BryanHaven/raven-animatronic/README.docx

Animatronic Bird Controller — v4.1

ESP32-based WiFi controller for animatronic props built around the Mr. Chicken's Prop Shop Animatronic Raven Kit and compatible builds. v4 adds a captive portal for first-time WiFi/MQTT setup, full runtime device configuration, and a three-level MQTT topic hierarchy. v4.1 hardens the firmware with OTA updates, hardware watchdog, MQTT last will, and WiFi auto-reconnect.

> Upgrading from v3? The only breaking change is that WiFi and MQTT credentials are no longer in raven_config.h. On first boot v4 will launch the setup AP.

# Version History

Version | Summary
v4.1.1 | Bug fixes: watchdog API corrected; captive portal validates required fields; firmware fallback populates blank name/hostname from Device ID
v4.1 | Show hardening: OTA firmware updates, hardware watchdog (30s), MQTT last will, WiFi auto-reconnect with exponential backoff
v4.0 | Captive portal setup (BirdSetup AP), runtime config.json, three-level MQTT hierarchy, Settings tab, Reset to AP mode, identity announcement
v3.0 | mDNS, live sequence indicator, SPIFFS-persisted servo calibration, keyframe sequence editor, MQTT Home Assistant discovery
v2.0 | I2S audio (MAX98357A), dynamic sound library, WAV upload via web UI
v1.0 | Initial release: DAC audio, static soundboard, ESPAsyncWebServer, WebSocket control

# Planned Features (v5+)

Feature | Notes
Kit-agnostic architecture | kit.json defines servo mapping, NeoPixel config, and personality per prop type
Glowing eyes | WS2812B/WS2813 LEDs behind glass lenses — daisy-chained on NeoPixel line as pixels 1 & 2, status LED becomes pixel 0. Eye color, effects, and blink timing defined per-kit in kit.json
Random idle behavior | Background task — random head/beak movements between cues, configurable interval
Conductor mode | One MQTT message fans out a timed sequence to multiple birds in a room
Startup sync | All birds in a room wait for a sync message before moving to neutral
Export/import config | Download full config as zip, clone to new bird by uploading
OTA SPIFFS update | Currently OTA covers firmware only — add filesystem update support
Physical trigger input | 3.5mm jack to GPIO 34, fires configurable sequence on contact closure
Current sensing | INA219 on VS+ rail — detect stalled/disconnected servos
Audio volume control | Configurable gain via MAX98357A GAIN pin
Audio ducking | Lower ambient audio level during cue sequences
Looping ambient audio | /audio/loop command for continuous background sound
Cue numbers | Numeric /cue topic mapping integers to sequence names for QLab/Isadora
Status LED | NeoPixel showing WiFi/MQTT/sequence state

# What's New in v4.1 — Show Hardening

- OTA firmware updates — flash new firmware over WiFi without USB. Password defaults to the device's Device ID.
- Hardware watchdog — 30-second timeout. If the firmware hangs the ESP32 automatically reboots.
- MQTT last will — the broker publishes offline to {prefix}/status when a bird drops off unexpectedly.
- WiFi auto-reconnect — retries with exponential backoff: 5s to 10s to 20s to 40s to 60s cap.

# What's New in v4.0

- Captive portal setup — on first boot the ESP32 becomes a WiFi access point called BirdSetup.
- Runtime device configuration — all identity, WiFi, and MQTT settings live in config.json on SPIFFS.
- Three-level MQTT topic hierarchy — location/room/device (e.g. props/tiki_bar/parrot1).
- Settings tab — edit device name, hostname, MQTT prefix, broker, and WiFi from the browser.
- Reset to AP mode — one button in Settings wipes config.json and restarts as BirdSetup.
- Identity announcement — on MQTT connect the bird publishes its name, hostname, IP, and full topic prefix.
- Multi-prop ready — flash the same firmware to every bird, configure each individually.

# Hardware

## Raven Mechanic Kit

Mr. Chicken's Prop Shop — Animatronic Raven Kit

https://chickenprops.com/products/animatronic-raven-kit

Available in Basic (mechanical parts only), Deluxe (Basic + servos), and Bare Bones (custom parts only).

## Servos

Qty | Part | Role
1x | Hitec HS-53 | Beak open/close
3x | Hitec HS-425BB | Head pan, head tilt, body bob
1x | Hitec HS-645MG | Wings (single servo, both wings mechanically linked)

## Electronics

Component | Exact Part | Notes
Microcontroller | DOIT ESP32 DevKit V1 (30-pin WROOM) | Any esp32dev board works
Carrier PCB | Raven Animatronic Controller PCB v1.0 | 100x60mm, JLCPCB fabricated — see /pcb directory
Servo Controller | Lynxmotion SSC-32U | USB + full-duplex UART
Audio Amplifier | Adafruit MAX98357A I2S Breakout — PID: 3006 | 3W Class D, I2S input
Speaker | Adafruit Mono Enclosed Speaker 3W 4 Ohm — PID: 4445 | 2.8 x 1.2 inch, bare wire leads
Current Monitor | INA219BIDR (SOIC-8) | Monitors servo current on +7.5V rail, I2C address 0x40
Servo PSU | Mean Well GST60A07-P1J (7.5V 5A, 37.5W) | See Power Supplies section
Logic PSU | Mean Well GST25A05-P1J (5V 4A, 20W) | Powers ESP32 + MAX98357A

# Power Supplies

Three separate power domains — keep them isolated.

## Domain 1 — Servos (6-7.5V, high current)

Mean Well GST60A07-P1J — 7.5V, 5A, 37.5W. The SSC-32U has an adjustable trimmer — trim down to 6V if your servos prefer it.

- IEC C14 inlet — requires IEC C13 power cord (not included)
- Connects to SSC-32U VS+ (red) and GND (black) terminals

## Domain 2 — ESP32 + Audio (5V, low current)

Mean Well GST25A05-P1J — 5V, 4A, 20W.

- Connects to ESP32 VIN; MAX98357A VIN connects to ESP32 5V pin

## Critical Ground Tie

SSC-32U GND -> ESP32 GND <- REQUIRED — UART won't work without this

> Add 100uF + 100nF bypass caps on MAX98357A VIN to suppress noise.

# Wiring

## ESP32 to SSC-32U (UART Serial)

> Carrier PCB v1.0: connect via J5 (XHB-4A). +7.5V servo power routed through R_SHUNT on the carrier board.

ESP32 Pin | J5 Pin | SSC-32U Pin | Notes
GPIO 17 (TX2) | 3 | RX | Commands to servo controller
GPIO 16 (RX2) | 2 | TX | Done signal back to ESP32
GND | 1 | GND | Common ground — required
+7.5V | 4 | VS+ | Servo power via R_SHUNT

## ESP32 to MAX98357A (I2S Audio)

> BCLK and LRC pins swapped from v4.x for PCB routing — update firmware defines.

ESP32 Pin | MAX98357A Pin | Notes
GPIO 26 | BCLK | Bit clock — swapped from v4.x GPIO 27
GPIO 27 | LRC | Left/Right clock — swapped from v4.x GPIO 14
GPIO 25 | DIN | Serial audio data
3.3V | SD_MODE | Tie high — always on
5V | VIN | Power
GND | GND | Common ground

GAIN pin: Float = 9dB (default) | GND = 12dB | 3.3V = 6dB

## ESP32 to INA219 (I2C Current Monitor)

> SDA and SCL pins swapped from v4.x defaults for PCB routing — update firmware defines.

ESP32 Pin | INA219 Pin | Notes
GPIO 22 | SDA | I2C data — swapped from v4.x GPIO 21
GPIO 21 | SCL | I2C clock — swapped from v4.x GPIO 22
3.3V | VS | Power
GND | GND | Common ground

I2C address: 0x40 (A0 and A1 tied to GND)

Shunt resistor R_SHUNT: 0.1 Ohm 2W 2512 on +7.5V rail between J3 and J5.

## NeoPixel Chain

The NeoPixel connector J8 (XHB-3A) supports a daisy-chained WS2812B/WS2813 LED string:

Pixel index | Function | Notes
0 | Status LED | Shows WiFi/MQTT/sequence state
1 | Eye left | Optional — enabled in kit.json
2 | Eye right | Optional — enabled in kit.json

For builds without eyes, set neopixel.count = 1 in kit.json.

WS2813 recommended for production props — dual data line prevents chain failure if one LED dies.

Add a 300-500 Ohm resistor in series on the DAT line at J8 for noise immunity.

## SSC-32U Servo Channel Map

Channel | Servo | Movement
CH 0 | Hitec HS-53 | Beak open / close
CH 1 | Hitec HS-425BB | Head pan — left / right
CH 2 | Hitec HS-425BB | Head tilt — up / down
CH 3 | Hitec HS-645MG | Wings (single servo, both wings mechanically linked)
CH 4 | — | Unused
CH 5 | Hitec HS-425BB | Body bob

# Carrier PCB

PCB design files are in the /pcb directory:

File | Description
Gerber_PCB1_2026-03-14.zip | Gerber files for JLCPCB fabrication
BOM_Board1_PCB1_2026-03-14.xlsx | Bill of Materials
CPL_JLCPCB.xlsx | Pick and Place file for JLCPCB assembly
firmware-pcb-v1-notes.md | Full pin change notes for v5.x firmware

Board specs: 100x60mm | 2-layer | 3mm corner radius | M3 corner mounting holes

## Connectors

Ref | Type | Function
J3 | XHB-3A | +7.5V power in (pin 1=+7.5V, pin 2=GND, pin 3=NC)
J4 | XHB-2A | +5V power in (pin 1=+5V, pin 2=GND)
J5 | XHB-4A | SSC-32U (pin 1=GND, pin 2=RX, pin 3=TX, pin 4=+7.5V)
J7b | XHB-3A | Trigger jack landing (pin 1=+3.3V, pin 2=SIG, pin 3=GND)
J8 | XHB-3A | NeoPixel (pin 1=+5V, pin 2=DAT, pin 3=GND)

Hand-install after JLCPCB assembly:

- DOIT ESP32 DevKit V1 30-pin (into H1/H2 female headers — LCSC C7499333)
- Adafruit MAX98357A breakout PID:3006 (into U2 header, secured with M2.5 screws at U8/U9)

# kit.json — NeoPixel / Eyes Configuration

The v5.x kit.json spec includes a neopixel block for per-kit LED personality:

## Parrot (with glowing eyes)

{

"kit": "parrot",

"neopixel": {

"count": 3,

"pixels": { "status": 0, "eye_left": 1, "eye_right": 2 },

"eyes": {

"enabled": true,

"idle_color": [255, 60, 0],

"idle_effect": "breathe",

"trigger_color": [255, 0, 0],

"trigger_effect": "snap",

"blink_enabled": true,

"blink_interval_min_ms": 3000,

"blink_interval_max_ms": 8000

}

}

}

## Raven (status LED only)

{

"kit": "raven",

"neopixel": {

"count": 1,

"pixels": { "status": 0 },

"eyes": { "enabled": false }

}

}

# Software Setup

## Prerequisites

- PlatformIO (VS Code extension recommended)

## 1. Upload filesystem

pio run --target uploadfs --environment esp32dev

## 2. Upload firmware

pio run --target upload --environment esp32dev

## 3. First-time setup via captive portal

- Power on the ESP32 — no config.json exists yet
- Connect to the BirdSetup WiFi network
- A setup page pops up automatically. If not, navigate to http://192.168.4.1
- Fill in all fields and click Save & Connect
- Navigate to http://[hostname].local (e.g. http://raven1.local)

## 4. Monitor serial output

pio device monitor --environment esp32dev

# Captive Portal Setup Fields

Field | Example | Notes
Device Name | Raven 1 | Display label in the web UI header
Hostname | raven1 | Used for http://raven1.local — lowercase, no spaces
Location | props | Top level of MQTT topic hierarchy
Room | study | Middle level — group of props in a space
Device ID | raven1 | Bottom level — unique per bird
MQTT Broker | homeassistant.local | Hostname or IP of your broker
MQTT Port | 1883 | Standard MQTT port
WiFi SSID | MyNetwork | Your WiFi network name
WiFi Password | •••••••• | Your WiFi password

# Multi-Prop Setup

Bird | Location | Room | Device | Full prefix
Raven 1 | props | study | raven1 | props/study/raven1
Raven 2 | props | study | raven2 | props/study/raven2
Parrot 1 | props | tiki_bar | parrot1 | props/tiki_bar/parrot1
Parrot 2 | props | tiki_bar | parrot2 | props/tiki_bar/parrot2

## MQTT Wildcard Broadcasting

props/study/raven1/sequence # One specific bird

props/tiki_bar/+/sequence # All birds in the tiki bar

props/+/+/sequence # Every bird in the show

# MQTT Topics

## Subscribe — Send to Bird

Leaf topic | Example payload | Effect
/command | beak_open, head_left, neutral | Single move
/sequence | caw, alert, wingflap, idle, sleep | Built-in sequence
/sequence | my_sequence_name | Saved keyframe sequence
/sound | caw | Play sound + bound sequence
/audio | caw | Audio only, no sequence
/servo | 0 1800 300 | Raw: channel, us, time ms
/query | all, sounds, sequences, identity | Request data

## Publish — Bird Sends

Leaf topic | Payload | When
/status | status string | After every action
/identity | JSON: name, hostname, ip, prefix | On connect + identity query
/sounds/list | JSON sound library | On connect + query
/sequences/list | JSON sequence names | On connect + query

# Troubleshooting

Symptom | Likely cause | Fix
BirdSetup AP doesn't appear | Firmware not flashed | Check serial output, reflash
Setup popup doesn't appear | Captive portal not triggered | Navigate to http://192.168.4.1 manually
raven1.local not found | mDNS blocked on network | Use IP address shown in serial output
Servos not responding | Wrong UART pins | Check GPIO 16/17 on carrier PCB v1.0
Servos jitter / ESP resets | Servo PSU on ESP32 rail | Isolate servo power to SSC-32U VS+ only
No audio | I2S wiring | Check GPIO 26/27/25 — changed from v4.x
I2C not working | SDA/SCL swapped | GPIO 22=SDA, GPIO 21=SCL on carrier PCB v1.0
MQTT not connecting | Wrong broker / port | Check Settings tab, verify broker is reachable
Need to change WiFi | — | Settings tab -> update SSID/password -> Save
Completely stuck | — | Settings tab -> Reset to Setup AP

# Resources

- Mr. Chicken's Build Resources: https://drive.google.com/drive/u/0/folders/1Ht4HYf0q8vE1VhdCadyyANCFJWSVyEcL
- Raven Builders Facebook Group: https://www.facebook.com/groups/185149192169022/
- Lynxmotion SSC-32U Documentation: https://www.lynxmotion.com/c-153-ssc-32u.aspx
- Adafruit MAX98357A Guide: https://learn.adafruit.com/adafruit-max98357-i2s-class-d-mono-amp
- Mean Well GST60A07-P1J Datasheet: https://www.meanwell.com/Upload/PDF/GST60A/GST60A-SPEC.PDF
- PlatformIO ESP32 Reference: https://docs.platformio.org/en/latest/boards/espressif32/esp32dev.html

Controller firmware developed with Claude (Anthropic). Raven mechanic kit by Mr. Chicken's Prop Shop / Jasper J. Anderson FX.
