BryanHaven/raven-animatronic/pcb/BOM_Board1_PCB1_2026-03-14.xlsx

No. | Quantity | Comment | Designator | Footprint | Value | Manufacturer Part | Manufacturer | Supplier Part | Supplier | JLCPCB Stock | JLCPCB Price
1 | 1 | 100uF | C1 | CAP-SMD_BD6.3-L6.6-W6.6-FD | 100uF | RST100UF16V003 | KNSCHA(科尼盛) | C4747963 | LCSC | 60217 | $0.0046
2 | 2 | 100nF | C2,C3 | C0603 | 100nF | CC0603KRX7R9BB104 | YAGEO(国巨) | C14663 | LCSC | 46722331 | $0.0004
3 | 1 | 1N4148W | D1 | SOD-123_L2.8-W1.8-LS3.7-RD-1 |  | 1N4148W | JSMSEMI(杰盛微) | C917030 | LCSC | 1887757 | $0.0009
4 | 3 | XHB-3A | J3,J7b,J8 | CONN-TH_XHB-3A |  | XHB-3A | CAX(创都) | C722899 | LCSC | 7029 | $0.0022
5 | 1 | XHB-2A | J4 | CONN-TH_XHB-2A_C2829622 |  | XHB-2A | FG(富港) | C2829622 | LCSC | 6412 | $0.0025
6 | 1 | XHB-4A | J5 | CONN-TH_4P-P2.50_HCTL_HC-XHB-4A |  | XHB-4A | DEALON(德艺隆) | C2904971 | LCSC | 8769 | $0.0037
7 | 3 | 10kΩ | R1,R2,R3 | R0603 | 10kΩ | FRC0603J103 TS | FOJAN(富捷) | C2930027 | LCSC | 14786555 | $0.0002
8 | 1 | 100mΩ | R_SHUNT | R2512 | 100mΩ | LRP12FTDSR100 | Viking(光颉) | C37635799 | LCSC | 542 | $0.0162
9 | 1 | ESP32-WROOM 30-pin dev board | U1 | ESP32-WROOM-30-DEVBOARD
10 | 1 | PM254V-11-07-H85 | U2 | HDR-TH_7P-P2.54-V-F |  | PM254V-11-07-H85 | XFCN(兴飞) | C2832270 | LCSC | 50306 | $0.0133
11 | 1 | INA219BIDR | U3 | SOIC-8_L5.0-W4.0-P1.27-LS6.1-BL |  | INA219BIDR | TI(德州仪器) | C2155799 | LCSC | 2795 | $0.1802
12 | 4 | MountingHole_3.2mm_M3 | U4,U5,U6,U7 | MountingHole_3.2mm_M3
13 | 2 | MountingHole:MountingHole_2.7mm_M2.5_Pad_Via | U8,U9 | MountingHole:MountingHole_2.7mm_M2.5_Pad_Via
14 | 2 | 1x15 Female Header 2.54mm | H1,H2 | Through Hole P=2.54mm |  | ZX-PM2.54-1-15PY | Megastar | C7499333 | LCSC | 21354 | $0.2012
