BryanHaven/raven-animatronic/(list of files, drawings)

Other design files:
pcb/ProPrj_Animatronic Bird Control Carrier Board_2026-03-15.epro
