BryanHaven/raven-animatronic/(commit log)

2026-03-11 fix: watchdog API, captive portal validation, blank name fallback (v4.1.1)
    - raven_watchdog.h: replace IDF 5.x esp_task_wdt_config_t/esp_task_wdt_reconfigure
    (not available in installed toolchain) with esp_task_wdt_init(timeout_s, panic);
    add comment explaining the API choice and toolchain constraint
    - raven_captive.h: add required-field validation for device_name and mdns_hostname
    in the portal save() function; blank values previously caused mDNS failure on boot
    - raven_device.h: fallback in deviceConfigLoad() populates device_name and
    mdns_hostname from mqtt_device if either is empty, ensuring mDNS always starts
    [raven_captive.h, raven_device.h, raven_watchdog.h]
2026-03-11 docs: add CONTRIBUTING.md
    Covers project overview, PlatformIO + VS Code setup, header-only
    architecture and dependency order, build/flash/monitor commands,
    coding conventions (naming, banners, logging tags, FreeRTOS tasks,
    ArduinoJson v7), PR process, and all planned v5+ features documented
    as good first issues with difficulty ratings and implementation notes.
2026-03-11 fix: consolidate to single wing servo (CH_WING replaces CH_WING_L/R)
    Physical hardware has one HS-645MG servo driving both wings mechanically.
    Removes CH_WING_L/CH_WING_R, adds CH_WING (ch 3). CH 4 is now unused.
    NUM_CHANNELS stays 6 to preserve keyframe file compatibility.
    - raven_config.h: CH_WING_L/R → CH_WING, comment noting single servo
    - raven_servo.h: wingsOut/wingsIn use single servoMove(); neutral() drops
    one wing entry (pairs count 12→10)
    - raven_webui.h: updateLivePos and livePos init use CH_WING
    - data/index.html: CH_NAMES[3] 'Wing L'→'Wing', CH_NAMES[4] 'Wing R'→'—';
    keyframe channel order comment updated
    - README.md: servo table and hardware table updated
    Co-Aut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
    [raven_config.h, raven_servo.h, raven_webui.h]
2026-03-12 Update README.md for Dynamic servo mapping future release
2026-03-13 Update README.md to include carrier board design
2026-03-13 Update README.md updated the carrier board design intent
2026-03-15 Created and added PCB files
    added project files for the PCB design - EasyEDA project files and build files -
    [BOM_Board1_PCB1_2026-03-14.xlsx, ProPrj_Animatronic Bird Control Carrier Board_2026-03-15.epro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]
2026-03-17 Update README.md - updated with project roadmap changes
    Hardware table — ESP32 corrected to 30-pin, carrier PCB and INA219 added
    Wiring tables — UART updated to GPIO 16/17 with J5 pinout, I2S BCLK/LRC swapped to 26/27, new INA219 I2C section, NeoPixel chain section
    Carrier PCB section — new, links to /pcb directory, connector pinout table, hand-install notes
    kit.json NeoPixel section — new, parrot and raven examples
    Planned Features — kit.json architecture and glowing eyes rows added
    Troubleshooting — new rows for GPIO changes
    File structure — /pcb directory added
2026-03-29 v4.1.3 — INA219 current monitor + audio bug fixes
    - Add raven_power.h: INA219 on I2C (SDA=22, SCL=21, 0x40) — reads bus
    voltage, current (mA), and power (mW) from the +7.5V servo rail
    - Publish power readings via MQTT (prefix/power), WebSocket push every
    5s, and GET /api/power
    - Fix init order: audioBegin() must precede powerBegin() — Wire.begin()
    before i2s_driver_install silently breaks I2S on this ESP32
    - Fix soundPlay() race: was calling audioPlay() then launchSequence(),
    which also calls audioPlay() — competing tasks caused silent playback;
    sequence now owns audio when one is bound, direct play only for
    seq=none sounds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
    [main.cpp, raven_audio.h, raven_config.h, raven_mqtt.h, raven_power.h, raven_webui.h]
2026-03-29 PCB v1.1 pre-fabrication hardware additions
    - MAX98357A GAIN → GPIO 33 (D33): 3-level volume control (LOW=12dB/float=9dB/HIGH=6dB)
    - MAX98357A SD_MODE → GPIO 32 (D32): firmware mute/ducking (replaces hard 3.3V tie)
    - TRIGGER_2_IN → GPIO 35 (D35): second 3.5mm trigger jack J9
    - SD card (VSPI): GPIO 18/19/23/5 + card detect GPIO 36; 100nF+10µF decoupling on VDD; 10kΩ pull-up on CS
    - I2C expansion header J10: SDA/SCL tapped from INA219 traces
    - Net names: TRIGGER_IN → TRIGGER_1_IN, TRIGGER2_IN → TRIGGER_2_IN
    - firmware-pcb-v1-notes.md: full EasyEDA change notes for all new signals
    - README: planned features table updated with GPIO assignments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
    [raven_config.h]
2026-03-30 PCB v1.1 power subsystem — Pololu D24V22F5 replaces AMS1117-5.0
    - Add PWR_GOOD (GPIO 39) to raven_config.h for Pololu PG pin
    - Add 5V regulator section to firmware-pcb-v1-notes.md with full
    EasyEDA change instructions, socket pinout, bypass cap BOM
    - Rename pin block heading to v1.1
    - Add pcb-v1.2-power-brief.md (full design brief for Pololu module)
    [raven_config.h]
2026-03-31 updates for PCB changes
